AEFeinstein/Super-2025-Swadge-HW/art/james/pcb-silk-longdog.png

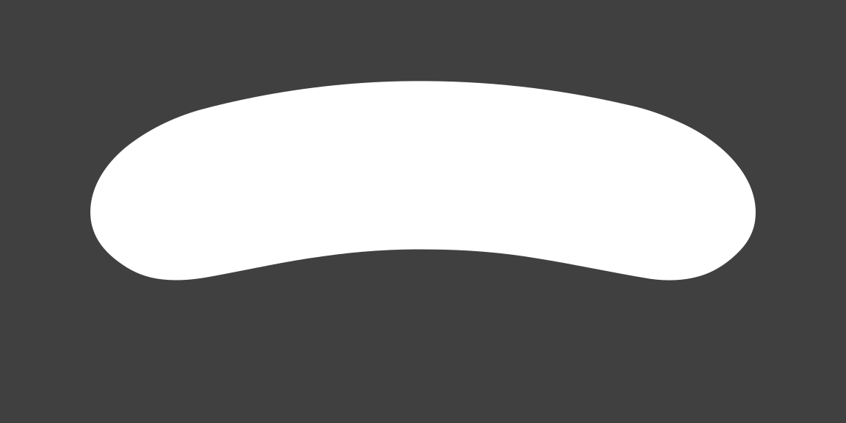
art/james/pcb-silk-longdog.png
