AEFeinstein/Super-2025-Swadge-HW/art/Silk rev A longdog.png

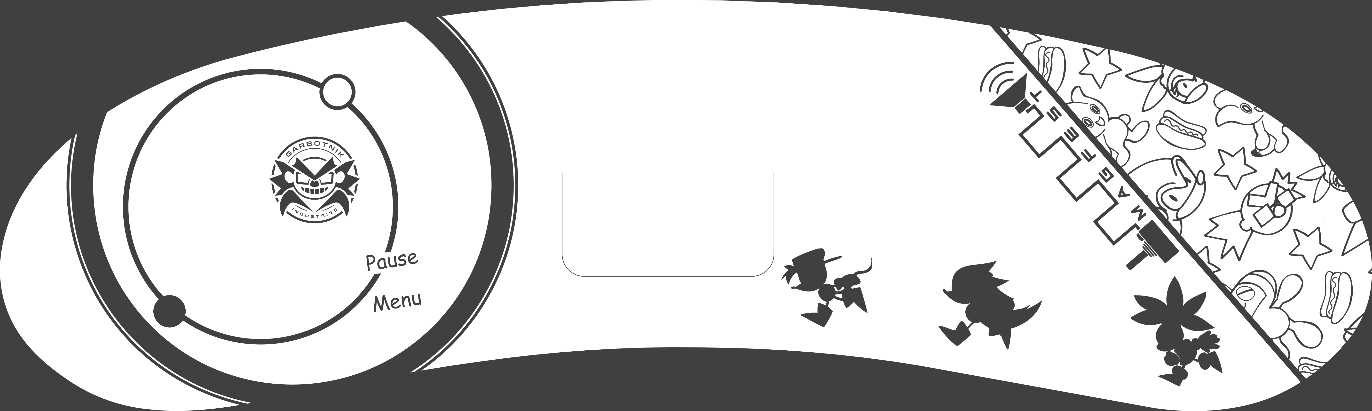
art/Silk rev A longdog.png
