AEFeinstein/Super-2025-Swadge-HW/Swadge-HW/Manufacturing Information/Hot Dog Quotation.xlsx

Sheet: PCB Specification
Your PCB Specification |  | Your PCB Specification
PCB Quantity | 725pcs | PCB Quantity | 1725pcs
Layer | 2layer | Layer | 2layer
PCB Thickness | 1.6mm | PCB Thickness | 1.6mm
Dimensions | 100mm*100mm | Dimensions | 100mm*100mm
Castellated Hole | No | Castellated Hole | No
PCB Color | Red | PCB Color | Black
Surface Finish | HASL Lead Free | Surface Finish | HASL Lead Free
Copper Weight | 1oz | Copper Weight | 1oz
Text Color | White | Text Color | White
Different Design | 1 | Different Design | 1
Please find more PCB information on our on-line PCB ordering Page
https://www.elecrow.com/pcb-manufacturing.html
 | Changelog:
October 11 2024 | Change PCB qty to 725 red + 1725 black, total qty 2450
October 11 2024 | Change surface finish to HASL LEAD FREE
October 11 2024 | Change C26 component
October 14 2024 | DNP U10, remove part from BOM and position file
October 14 2024 | DNP C21, remove part from BOM and position file
October 21 2014 | Add R19

Sheet: BOM
Project Name
# | Reference | QTY | Value | Package | Manufacturer Part number | Description | SMD | THT | Original | Elecrow PN | Note
1 | BT1, BT2, BT3 | 3 | Battery | 2460 | 36-2460-ND |  |  | 3 |  |  | Use through-hole AA Battery Holder in Style of Keystone 2460. Two fins hold batteries, not four fins.
2 | C1, C11, C14, C15, C17, C19, C24, C4, C5, C6 | 10 | 1μF | C_0603_1608Metric |  |  | 10 |  |  | C15849
3 | C10, C13, C16, C23, C25, C3 | 6 | 0.1μF | C_0603_1608Metric |  |  | 6 |  |  | C282519
4 | C12, C2, C20, C22, C7 | 5 | 22μF | C_0603_1608Metric |  |  | 5 |  |  | C159801
5 | C18 | 1 | 0.39uF | C_0603_1608Metric |  |  | 1 |  |  | C376833
6 | C26 | 1 | 470uF | C_Radial_D6.3_L5.8_P5.34 |  |  | 1 |  |  | C7465562
7 | C9 | 1 | 4.7nF | C_0603_1608Metric |  |  | 1 |  |  | C53987
8 | D1, D2, D3, D4, D5, D6, D7, D8, D9 | 9 | LC8812B-4020 | 4020PAD |  |  | 9 |  |  | C5446701
9 | D10, D12 | 2 | D | D_SMA | 2616-GS1J-ND |  | 2 |  |  | C22452
10 | D11 | 1 | SP0503BAHT | SOT-143 | F2715CT-ND |  | 1 |  |  | C2682275
11 | J1 | 1 | SAO | PinSocket_2x03_P2.54mm_Vertical | SFH11-PBPC-D03-ST-BK-ND |  |  | 1 |  | C92272
12 | J2 | 1 | PJ-307C | PJ-307C |  |  |  | 1 |  | C16684
13 | L1 | 1 | 33uH_500mA | L_1210_3225Metric |  |  | 1 |  |  | C90317
14 | L3 | 1 | 2.2uH | L_1008_2520Metric |  |  | 1 |  |  | C216158
15 | MK1 | 1 | Microphone | INGHAi_MIC_GMI4013S-2C58DB |  |  | 1 |  |  | C529870
16 | P1 | 1 | USB_C_Plug_USB2.0 | USB_C_Receptacle_HRO_TYPE-C-31-M-12 |  |  |  | 1 |  | C2765186 | https://www.usb.org/sites/default/files/documents/usb_type-c.zip
17 | Q1 | 1 | Q_PMOS_GSD | SOT-23 |  |  | 1 |  |  | C2763847
18 | R1, R22, R24, R26, R7 | 5 | 10kΩ | R_0603_1608Metric |  |  | 5 |  |  | C25804
19 | R10, R11, R12, R15, R16, R17 | 6 | 510Ω | R_0603_1608Metric |  |  | 6 |  |  | C2907048
20 | R13, R14, R2, R4, R8 | 5 | 33Ω | R_0603_1608Metric |  |  | 5 |  |  | C23140
21 | R18, R27, R28, R6 | 4 | 5.1kΩ | R_0603_1608Metric |  |  | 2 |  |  | C23186
22 | R21, R25 | 2 | 43kΩ | R_0603_1608Metric |  |  | 2 |  |  | C23172
23 | R3 | 1 | 12kΩ | R_0603_1608Metric |  |  | 1 |  |  | C22790
24 | R5, R9 | 2 | 20kΩ | R_0603_1608Metric |  |  | 2 |  |  | C2907011
25 | R19 | 1 | 120Ω | R_0603_1608Metric |  |  | 1 |  |  | C313655
26 | RV1 | 1 | R_Potentiometer_US_SMD | RK10J11R001Y |  |  | 1 |  |  | C3020613
27 | SW1, SW2, SW3, SW4, SW5, SW6 | 6 | YTS-D003-1A | YTS-D003-1A | 2223-TS04-66-65-BK-100-SMT-ND |  | 6 |  |  | C2910918 | Use low operating force (100gf) SMT box tactile buttons
28 | SW7, SW8 | 2 | B3FS-4002P | B3FS4002P | SW1278CT-ND |  | 2 |  |  | C2929546 | Use standard 12mmx12mm SMT box tactile buttons with flat top. Similar to TS-1103S-B-A.
29 | SW9 | 1 | SW_SPDT_1825232-1 | 1825232-1 | A107673-ND |  |  | 1 |  | C393937 | Use SPDT slide switch. Similar to 1825232-1
30 | U1 | 1 | ESP32-S2-MINI-1 | ESP32-S2-MINI-1 |  |  | 1 |  |  | C3013908 | Use module w. 4MB Flash, 2MB PSRAM (N4R2)
31 | U2 | 1 | RB017A1505A | NULL | http://www.ronboe.com/index.html |  |  | 1 |  |  | Display
32 | U3 | 1 | MT3410 | SOT-23-5 |  |  | 1 |  |  | C883494 | May be FP6396, M3406, LP3220S, etc...
33 | U5 | 1 | RB017A1505A_Connector | HCTL HC-FPC-03-10-15RLTAG | A141392TR-ND |  | 1 |  |  | C3012328
34 | U6 | 1 | LSM6DSL | LGA-14_3x2.5mm_P0.5mm_LayoutBorder3x4y |  |  | 1 |  |  | C967633
35 | U7 | 1 | GENERIC_LDO_2.8 | SOT-23 |  |  | 1 |  |  | C347374
36 | U8 | 1 | FM8002A | SOP-8_3.9x4.9mm_P1.27mm |  |  | 1 |  |  | C94625
37 | U9 | 1 | INGHAi_GSPK2307P-8R1W | INGHAi GSPK2308P-8R0.5W | 102-2500-ND |  |  | 1 |  | C530531
 |  |  |  |  |  | total： | 79 | 9
 | Declare：
 | 1、If the component should be original like Digi-key or Mouser，the component must have complete Manufacture part number

Sheet: Parts Mapping
TOP
BOTTOM

Sheet: Position File
designator | footprint | pos_x | pos_y | layer | rotation
BT1 | 2460 | 211.806 | -110.3999 | bottom | 100
BT2 | 2460 | 155.955 | -102.55 | bottom | 180
BT3 | 2460 | 103.314 | -107.7499 | bottom | -100
C1 | C_0603_1608Metric | 157.6413 | -69.0099 | bottom | 172
C10 | C_0603_1608Metric | 138.3615 | -119.986 | bottom | 180
C11 | C_0603_1608Metric | 150.7 | -82 | bottom | -90
C12 | C_0603_1608Metric | 136.95 | -123.1 | bottom | 180
C13 | C_0603_1608Metric | 139.3 | -125.35 | bottom | -90
C14 | C_0603_1608Metric | 139.3 | -88.0965 | bottom | 180
C15 | C_0603_1608Metric | 129.35 | -88.8375 | bottom | 90
C16 | C_0603_1608Metric | 150.0955 | -71.078 | bottom | 180
C17 | C_0603_1608Metric | 120.3 | -117.3245 | bottom | 15
C18 | C_0603_1608Metric | 142.5 | -91.05 | bottom | 0
C19 | C_0603_1608Metric | 147.45 | -68.5375 | bottom | -90
C2 | C_0603_1608Metric | 176.6815 | -73.3059 | bottom | -8
C20 | C_0603_1608Metric | 172.1 | -91.8 | bottom | 180
C22 | C_0603_1608Metric | 142.1875 | -77.65 | bottom | -90
C23 | C_0603_1608Metric | 145.02 | -67.7381 | bottom | 180
C24 | C_0603_1608Metric | 136.2875 | -131.05 | bottom | 150
C25 | C_0603_1608Metric | 145.02 | -69.4021 | bottom | 180
C26 | C_Radial_D6.3_L5.8_P5.34 | 118.7 | -105.6 | bottom | 0
C3 | C_0603_1608Metric | 176.465 | -74.8468 | bottom | -8
C4 | C_0603_1608Metric | 195.3375 | -117.65 | bottom | -15
C5 | C_0603_1608Metric | 154.3425 | -68.9 | bottom | 180
C6 | C_0603_1608Metric | 117.7666 | -125.5217 | bottom | -165
C7 | C_0603_1608Metric | 118.8086 | -127.8172 | bottom | -75
C9 | C_0603_1608Metric | 181.5 | -91.8 | bottom | 180
D1 | 4020PAD | 195.5392 | -116.0988 | top | 165
D10 | D_SMA | 146.3 | -82.6 | bottom | 0
D11 | SOT-143 | 182.694 | -127.5766 | bottom | -105
D12 | D_SMA | 179.1247 | -130.8254 | bottom | -15
D2 | 4020PAD | 209.9748 | -78.7385 | top | -30
D3 | 4020PAD | 156.543 | -67.5 | top | 0
D4 | 4020PAD | 98.3965 | -82.3592 | top | 40
D5 | 4020PAD | 119.4684 | -115.7178 | top | -165
D6 | 4020PAD | 104.4072 | -133.6721 | top | -38
D7 | 4020PAD | 137.3248 | -129.9215 | top | -30
D8 | 4020PAD | 170.3022 | -117.6524 | top | 144
D9 | 4020PAD | 214.6653 | -132.6465 | top | 130
J1 | PinSocket_2x03_P2.54mm_Vertical | 181.5965 | -71.2037 | top | 77
J2 | PJ-307C | 132.3093 | -68.0846 | bottom | -170
J3 | PinHeader_1x05_P2.54mm_Vertical | 191.979 | -71.4433 | bottom | -107
L1 | L_1210_3225Metric | 144.6 | -78.4 | bottom | 90
L3 | L_1008_2520Metric | 119.3434 | -131.6794 | bottom | 15
MK1 | INGHAi_MIC_GMI4013S-2C58DB | 177.7 | -103.4 | top | 0
P1 | USB_C_Receptacle_HRO_TYPE-C-31-M-12 | 187.0171 | -136.5052 | bottom | 165
Q1 | SOT-23 | 148.1 | -78.9 | bottom | 180
R1 | R_0603_1608Metric | 157.3629 | -70.9904 | bottom | -8
R10 | R_0603_1608Metric | 218.8959 | -92.5969 | bottom | -80
R11 | R_0603_1608Metric | 199.4067 | -96.3748 | bottom | -80
R12 | R_0603_1608Metric | 198.316 | -110.2211 | bottom | -74
R13 | R_0603_1608Metric | 188.2168 | -128.1482 | bottom | -105
R14 | R_0603_1608Metric | 190.1486 | -128.6659 | bottom | -105
R15 | R_0603_1608Metric | 202.5258 | -116.4901 | bottom | -39
R16 | R_0603_1608Metric | 225.2352 | -107.5296 | bottom | -90
R17 | R_0603_1608Metric | 197.5677 | -102.2035 | bottom | -15
R18 | R_0603_1608Metric | 142 | -118 | bottom | 0
R19 | R_0603_1608Metric | 138.7 | -77.6375 | bottom | 90
R2 | R_0603_1608Metric | 175.25 | -91.8 | bottom | 180
R21 | R_0603_1608Metric | 123.5374 | -130.4454 | bottom | 105
R22 | R_0603_1608Metric | 124.7597 | -128.8928 | bottom | 105
R24 | R_0603_1608Metric | 123.828 | -125.9455 | bottom | 105
R25 | R_0603_1608Metric | 120.7762 | -124.7282 | bottom | -165
R26 | R_0603_1608Metric | 140.444 | -77.65 | bottom | -90
R27 | R_0603_1608Metric | 186.2849 | -127.6306 | bottom | -105
R28 | R_0603_1608Metric | 192.0805 | -129.1835 | bottom | -105
R3 | R_0603_1608Metric | 178.4 | -91.8 | bottom | 0
R4 | R_0603_1608Metric | 193.55 | -113.0625 | bottom | 90
R5 | R_0603_1608Metric | 136.1745 | -85.59 | bottom | 0
R6 | R_0603_1608Metric | 145 | -118 | bottom | 0
R7 | R_0603_1608Metric | 150.7 | -78.9 | bottom | 90
R8 | R_0603_1608Metric | 136.95 | -124.7 | bottom | 180
R9 | R_0603_1608Metric | 139.3 | -91.05 | bottom | 180
RV1 | RK10J11R001Y | 118.8665 | -73.302 | bottom | -152
SW1 | YTS-D003-1A | 105.7931 | -91.5931 | top | -45
SW2 | YTS-D003-1A | 111.45 | -97.25 | top | -135
SW3 | YTS-D003-1A | 100.1363 | -97.25 | top | 45
SW4 | YTS-D003-1A | 105.7931 | -102.9069 | top | 135
SW5 | YTS-D003-1A | 123.0715 | -108.7693 | top | -170
SW6 | YTS-D003-1A | 121.8351 | -101.7575 | top | -170
SW7 | B3FS4002P | 183.519 | -91.519 | top | 110
SW8 | B3FS4002P | 195.119 | -85.969 | top | 110
SW9 | 1825232-1 | 123.1681 | -134.7676 | bottom | -165
U1 | ESP32-S2-MINI-1 | 166.3469 | -77.0707 | bottom | 172
U2 | NULL | 69.0335 | -217.4483 | top | 0
U3 | SOT-23-5 | 121.4606 | -127.3789 | bottom | 105
U5 | HCTL HC-FPC-03-10-15RLTAG | 142.3 | -70.91 | top | 0
U6 | LGA-14_3x2.5mm_P0.5mm_LayoutBorder3x4y | 140.324 | -122.2735 | bottom | 180
U7 | SOT-23 | 150.046 | -68.468 | bottom | 0
U8 | SOP-8_3.9x4.9mm_P1.27mm | 133.981 | -89.099 | bottom | 180
U9 | INGHAi GSPK2308P-8R0.5W | 123.0569 | -85.5883 | top | -3
