AEFeinstein/Super-2025-Swadge-HW/Swadge-HW/Manufacturing Information/Template-for-PCBA-Quotation.xlsx

Sheet: PCB Specification
Your PCB Specification
PCB Quantity | 1000pcs
Layer | 2layer
PCB Thickness | 1.6mm
Dimensions | 100mm*100mm
Castellated Hole | No
PCB Color | Blue
Surface Finish | HASL Lead Free
Copper Weight | 1oz
Text Color | White
Different Design | 1
Please find more PCB information on our on-line PCB ordering Page
https://www.elecrow.com/pcb-manufacturing.html

Sheet: BOM
Project Name
# | Reference | QTY | Value | Package | Manufacturer Part number | Description | SMD | THT | Original | Elecrow PN | Note
1 | BUZZ | 1 | PKMCS0909E4000-R1 | PKMCS0909E4000-R1 | 490-9647-1-ND |  | 2 |  | Y
2 | C1,C3-5 | 4 | 0.1u | CJ1608 | 609-3263-ND | Capacitors | 8 |  | N | 2013010A
3 | C2,C6 | 2 | 4.7u | CJ1608 | 609-3263-ND | Capacitors | 4 |  | N | 2014547A
4 | CN1 | 1 | AVRISP | 2X3_PINHEADER_SMD | WM17449-ND |  | 6 |  | N
5 | D1 | 1 | 1N4148WS | SOD323 | 609-3263-ND |  | 2 |  | Y | 4010541A
6 | IC1 | 1 | ATMEGA328P-20MU | QFN32-0.5 | ATMEGA328P-MU-ND | ATMEL AVR | 32 |  | Y
7 | IC2 | 1 | TCR2EF33LM | SOT-23-5PIN | TCR2EF33LM(CTCT-ND |  | 5 |  | Y
8 | JP1 | 1 |  | JST-2-SMD | 455-1749-1-ND | Header 2 | 4 |  | N
9 | JP4 | 1 | FTDI Basic | 1X06 | 609-3263-ND |  |  | 6 | N
10 | LED1 | 1 | OSTG1608C1A | CHIP-LED0603 | 609-3264-ND | LED | 2 |  | N | 4040706A
11 | R1,R13 | 2 | 1k | RJ1608 | 609-3268-ND | Resistors | 4 |  | N | 1022501A
12 | R2 | 1 | 100k | RJ1608 | 609-3269-ND | Resistors | 2 |  | N | 10240102A
13 | R3,R6,R7,R12 | 4 | 330 | RJ1608 | 609-3270-ND | Resistors | 8 |  | N | 1021633A
14 | R4,R5,R8,R10,R11, | 5 | 10k | RJ1608 | 609-3271-ND | Resistors | 16 |  | N | 1023510A
15 | R9 | 1 | 2k | RJ1608 | 609-3272-ND | Resistors | 2 |  | N | 1022622B
16 | VR1 | 1 | 50k |  | CT6EP503-ND |  |  | 3 | N
17 | RESET,SW2-4 | 4 | PUSHSW2-6X6 | ALPS-SKHH | CT6EP504-ND |  |  | 16 | N | 7020644A
18 | T1,T2 | 2 | 2SC2712 | SOT23-BEC | 2SC2712-GRLFCT-ND | NPN Transistor | 6 |  | Y
19 | T3-5 | 3 | BSS138 | SOT-23 | BSS138CT-ND |  | 9 |  | Y
20 | U2 | 1 | MCP73831 | SOT-23-5PIN | MCP73831T-2ACI/OTCT-ND |  | 5 |  | Y
21 | U3 | 1 |  | USB-MICRO-SMD | MCP73831T-3ACI/OTCT | This is a USB AB connector that is compatible with USB OTG. i.e. this connector can serve as a host or device | 7 |  | N | 6020800A
22 | Y1 | 1 | RESONATORPBRC-M | PBRC-M | 1253-1018-1-ND | Resonator | 3 |  | N
 |  |  |  |  |  | total： | 127 | 25
 | Declare：
 | 1、If the component should be original like Digi-key or Mouser，the component must have complete Manufacture part number

Sheet: Position File
Designator | Footprint | Center-X(mm) | Center-Y(mm) | Layer | Rotation
R27 | R0603 | 80478 | 54614 | BottomLayer | 360
R27 | R0603 | 126678 | 54614 | BottomLayer | 360
R27 | R0603 | 80478 | 23614 | BottomLayer | 360
R27 | R0603 | 126678 | 23614 | BottomLayer | 360
R26 | R0603 | 70648 | 54995 | BottomLayer | 360
R26 | R0603 | 116848 | 54995 | BottomLayer | 360
R26 | R0603 | 70648 | 23995 | BottomLayer | 360
R26 | R0603 | 116848 | 23995 | BottomLayer | 360
R25 | R0603 | 80478 | 56646 | BottomLayer | 180
R25 | R0603 | 126678 | 56646 | BottomLayer | 180
R25 | R0603 | 80478 | 25646 | BottomLayer | 180
R25 | R0603 | 126678 | 25646 | BottomLayer | 180
R24 | R0603 | 70648 | 57027 | BottomLayer | 180
R24 | R0603 | 116848 | 57027 | BottomLayer | 180
R24 | R0603 | 70648 | 26027 | BottomLayer | 180
R24 | R0603 | 116848 | 26027 | BottomLayer | 180
Q21 | SOT-23 | 77010 | 55683 | BottomLayer | 90
Q21 | SOT-23 | 123210 | 55683 | BottomLayer | 90
Q21 | SOT-23 | 77010 | 24683 | BottomLayer | 90
Q21 | SOT-23 | 123210 | 24683 | BottomLayer | 90
Q20 | SOT-23 | 65949 | 56036 | BottomLayer | 90
Q20 | SOT-23 | 112149 | 56036 | BottomLayer | 90
Q20 | SOT-23 | 65949 | 25036 | BottomLayer | 90
Q20 | SOT-23 | 112149 | 25036 | BottomLayer | 90
Q2 | SOT95P240X120-3N | 36573 | 27516 | BottomLayer | 180
Q2 | SOT95P240X120-3N | 7573 | 27516 | BottomLayer | 180
Q2 | SOT95P240X120-3N | 36573 | 58516 | BottomLayer | 180
Q2 | SOT95P240X120-3N | 7573 | 58516 | BottomLayer | 180
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
C5 | C0805 | 47434 | 46748 | TopLayer | 90
C5 | C0805 | 18434 | 46748 | TopLayer | 90
C2 | C0805 | 36258 | 28067 | TopLayer | 180
C2 | C0805 | 7258 | 28067 | TopLayer | 180
C2 | C0805 | 36258 | 59067 | TopLayer | 180
C2 | C0805 | 7258 | 59067 | TopLayer | 180
