AEFeinstein/Super-2025-Swadge-HW/art/james/condiment-longdog.dxf

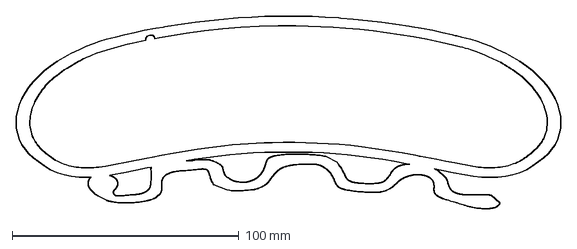
[picture p3: CAD file, 2024-11-29]
art/james/condiment-longdog.dxf
240.1 x 84.8 mm
