AEFeinstein/Super-2025-Swadge-HW/Swadge-HW/Manufacturing Information/condiment.dxf

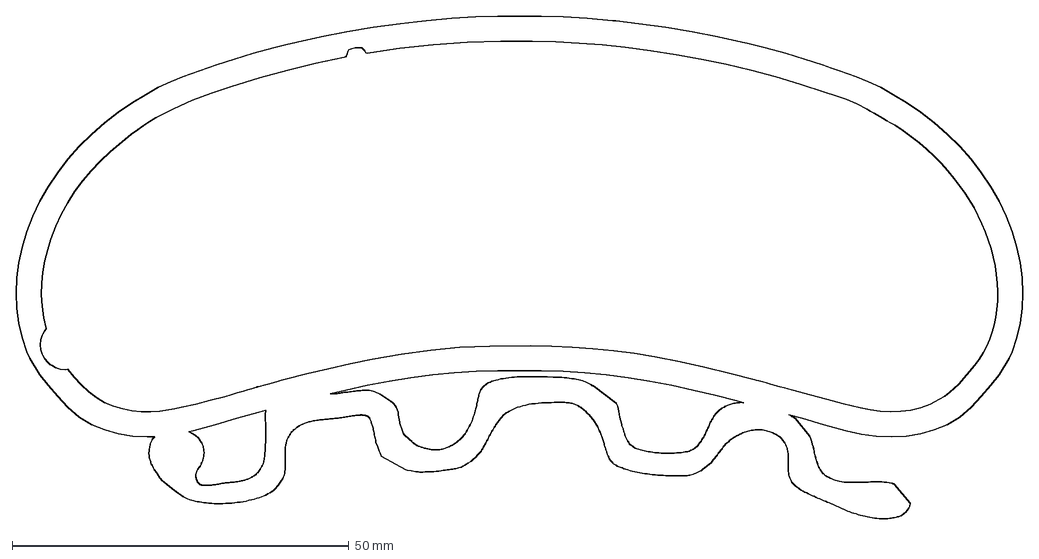
[picture p4: CAD file, 2024-11-15]
Swadge-HW/Manufacturing Information/condiment.dxf
149.5 x 74.6 mm
