AEFeinstein/Super-2025-Swadge-HW/Swadge-HW/package3d/condiment.step

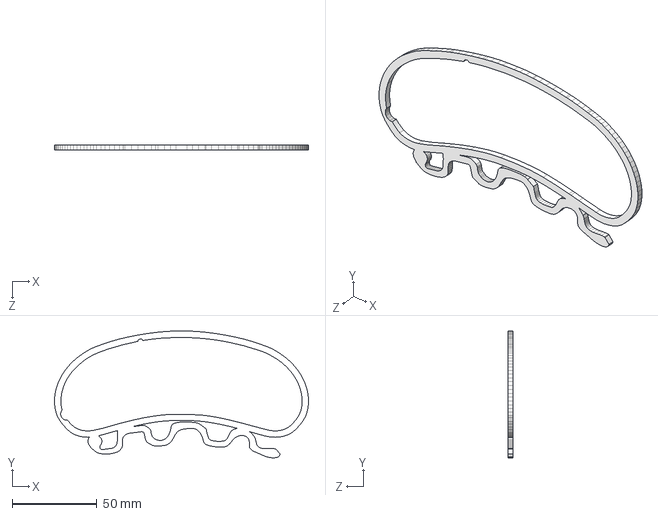
[picture p5: CAD file, 2024-11-15]
Swadge-HW/package3d/condiment.step
149.5 x 74.6 x 3.00 mm
