AEFeinstein/Super-2025-Swadge-HW/Swadge-HW/Swadge-HW.kicad_pcb

## KiCad design Swadge-HW/Swadge-HW.kicad_pcb (2024-11-20)

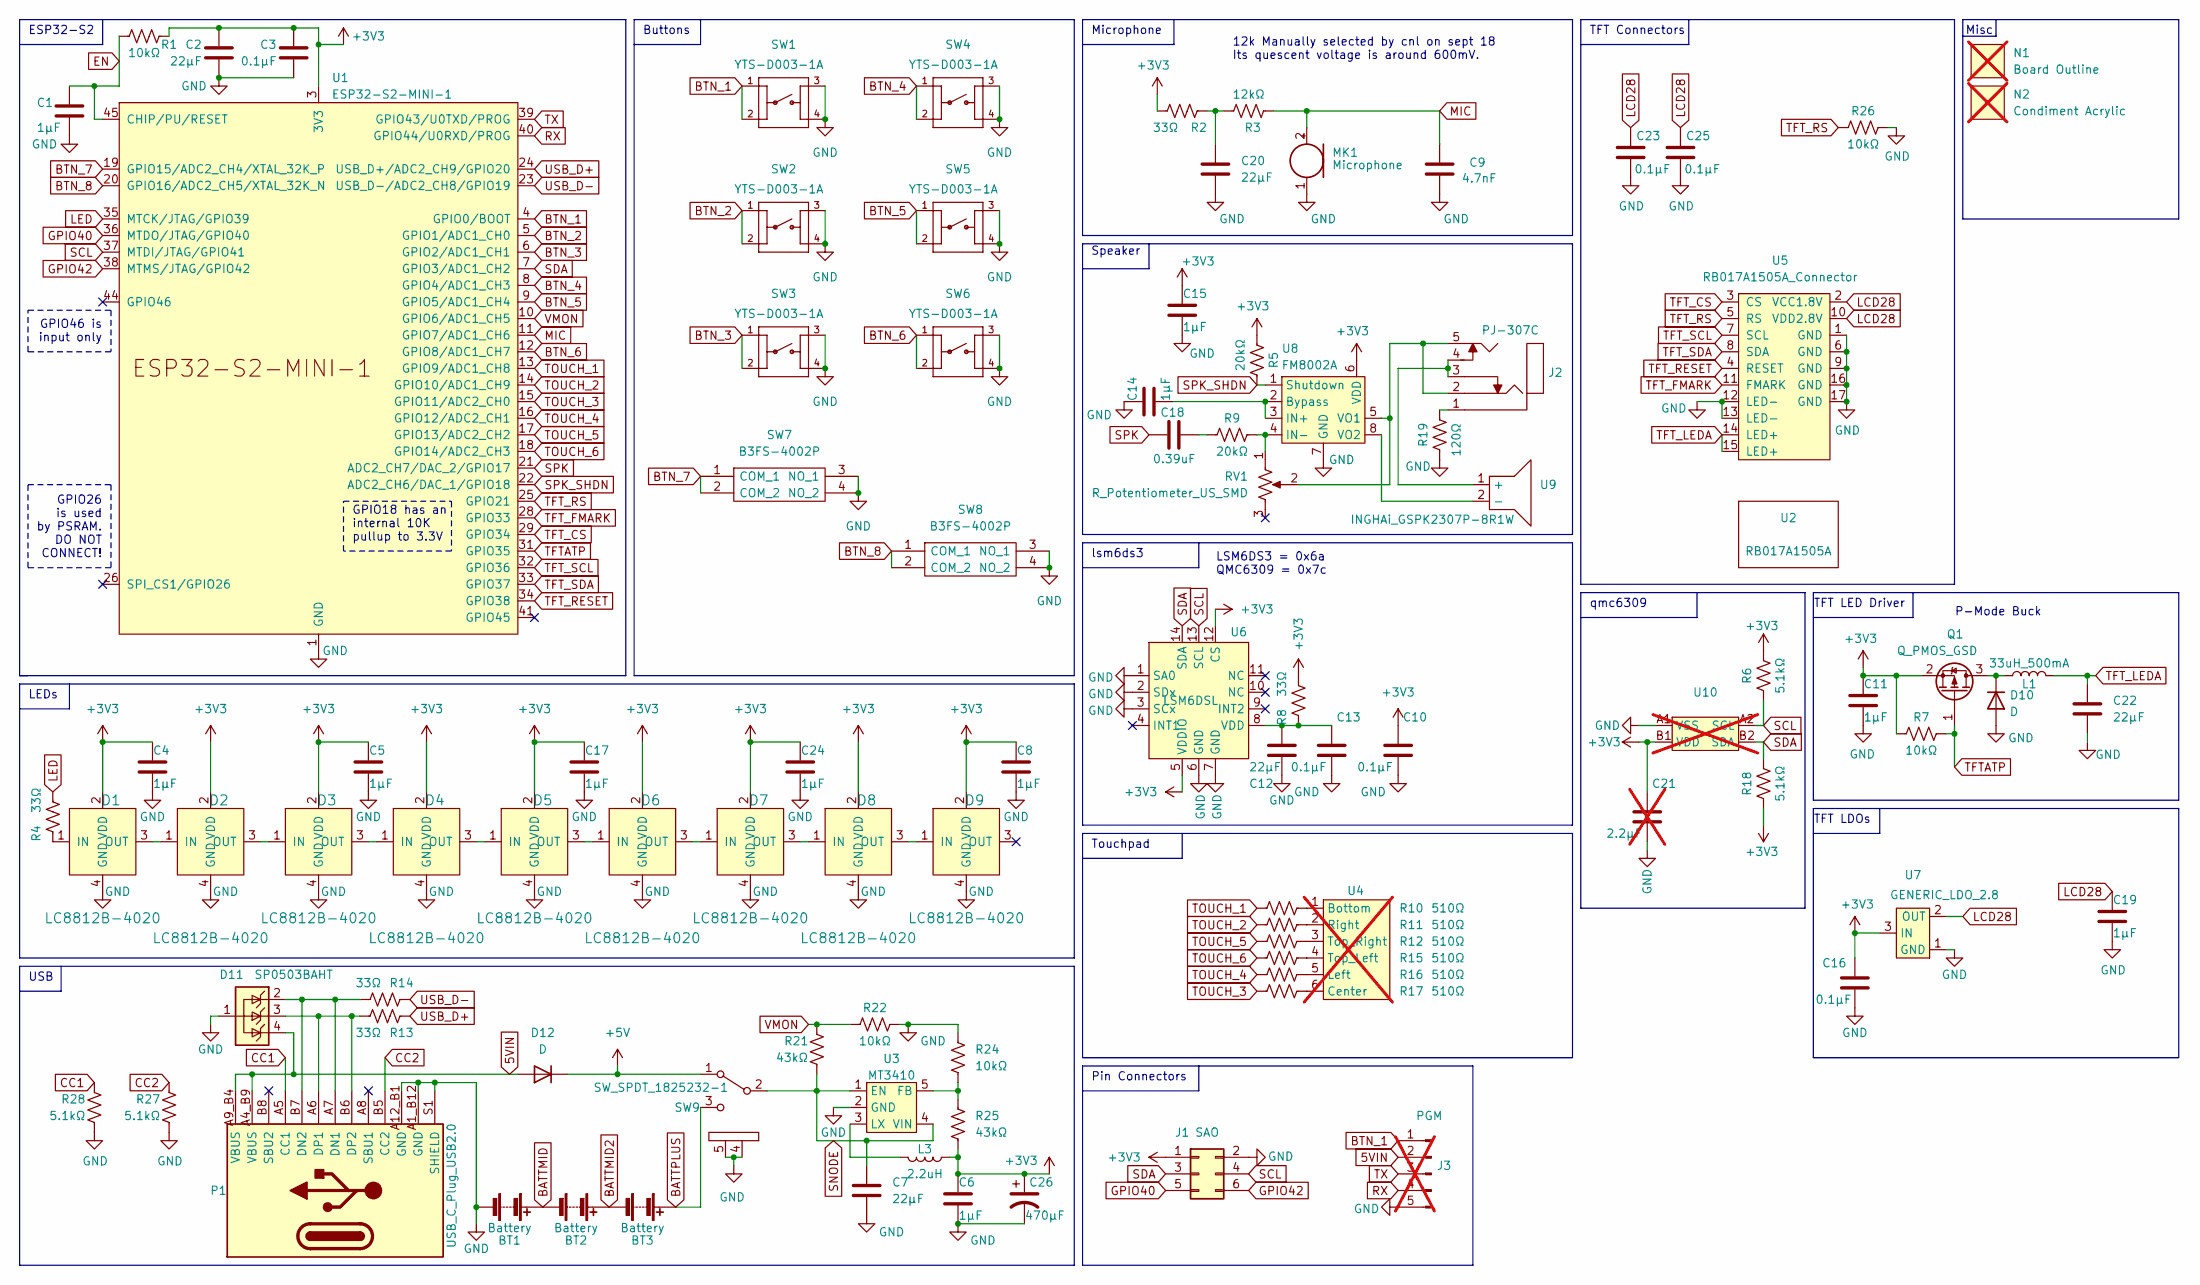
[picture p6: schematic Swadge-HW.kicad_sch]

Parts:
BT1, BT2, BT3: Battery; 2460; Digikey 36-2460-ND
C1, C4, C5, C6, C8, C11, C14, C15, C17, C19, C24: 1μF; C_0603_1608Metric; LCSC C15849
C2, C7, C12, C20, C22: 22μF; C_0603_1608Metric; LCSC C159801
C3, C10, C13, C16, C23, C25: 0.1μF; C_0603_1608Metric; LCSC C282519
C9: 4.7nF; C_0603_1608Metric; LCSC C53987
C18: 0.39uF; C_0603_1608Metric; LCSC C376833
C21: 2.2μF; C_0603_1608Metric; LCSC C6119848; not fitted
C26: 470μF; C_Radial_D6.3_L5.8_P5.34; LCSC C7465562
D1, D2, D3, D4, D5, D6, D7, D8, D9: LC8812B-4020; 4020PAD; LCSC C5446701
D10, D12: D; D_SMA; Digikey 2616-GS1J-ND
D11: SP0503BAHT; SOT-143; Digikey F2715CT-ND
J1: SAO; PinSocket_2x03_P2.54mm_Vertical; LCSC C92272
J2: PJ-307C; LCSC C16684
J3: PGM; PinHeader_1x05_P2.54mm_Vertical; not fitted
L1: 33uH_500mA; L_1210_3225Metric; LCSC C90317
L3: 2.2uH; L_1008_2520Metric; LCSC C216158
MK1: Microphone; INGHAi_MIC_GMI4013S-2C58DB; LCSC C529870
N1: Board Outline; hotdog-outline; not fitted
N2: Condiment Acrylic; condiment; not fitted
P1: USB_C_Plug_USB2.0; USB_C_Receptacle_HRO_TYPE-C-31-M-12; LCSC C2765186
Q1: Q_PMOS_GSD; SOT-23; LCSC C2763847
R1, R7, R22, R24, R26: 10kΩ; R_0603_1608Metric; LCSC C25804
R2, R4, R8, R13, R14: 33Ω; R_0603_1608Metric; LCSC C23140
R3: 12kΩ; R_0603_1608Metric; LCSC C22790
R5, R9: 20kΩ; R_0603_1608Metric; LCSC C2907011
R6, R18, R27, R28: 5.1kΩ; R_0603_1608Metric; LCSC C23186
R10, R11, R12, R15, R16, R17: 510Ω; R_0603_1608Metric; LCSC C2907048
R19: 120Ω; R_0603_1608Metric; LCSC C313655
R21, R25: 43kΩ; R_0603_1608Metric; LCSC C23172
RV1: R_Potentiometer_US_SMD; RK10J11R001Y; LCSC C3020613
SW1, SW2, SW3, SW4, SW5, SW6: YTS-D003-1A; Digikey 2223-TS04-66-65-BK-100-SMT-ND
SW7, SW8: B3FS-4002P; B3FS4002P; Digikey SW1278CT-ND
SW9: SW_SPDT_1825232-1; 1825232-1; Digikey A107673-ND
U1: ESP32-S2-MINI-1; LCSC C3013908
U2: RB017A1505A; NULL
U3: MT3410; SOT-23-5; LCSC C883494
U4: Touch_Teeth_5b; not fitted
U5: RB017A1505A_Connector; HCTL HC-FPC-03-10-15RLTAG; Digikey A141392TR-ND
U6: LSM6DSL; LGA-14_3x2.5mm_P0.5mm_LayoutBorder3x4y; LCSC C967633
U7: GENERIC_LDO_2.8; SOT-23; LCSC C347374
U8: FM8002A; SOP-8_3.9x4.9mm_P1.27mm; LCSC C94625
U9: INGHAi_GSPK2307P-8R1W; INGHAi GSPK2308P-8R0.5W; Digikey 102-2500-ND
U10: BGA-4-.83x.83; LCSC C5439871; not fitted

Connections:
5VIN: D11.4 (K), D12.2 (A), J3.2, P1.A4_B9 (VBUS), P1.A9_B4 (VBUS)
+3V3: C2.1, C3.1, C4.1, C5.1, C6.1, C8.1, C10.1, C11.1, C15.1, C16.1, C17.1, C21.1, C24.1, C26.1, D1.2 (VDD), D2.2 (VDD), D3.2 (VDD), D4.2 (VDD), D5.2 (VDD), D6.2 (VDD), D7.2 (VDD), D8.2 (VDD), D9.2 (VDD), J1.1, L3.1, Q1.2 (S), R1.1, R2.2, R5.1, R6.2, R7.1, R8.2, R18.1, R25.2, U1.3 (3V3), U6.5 (VDDIO), U6.12 (CS), U7.3 (IN), U8.6 (VDD), U10.B1 (VDD)
+5V: D12.1 (K), SW9.1 (A)
BATTMID: BT1.1 (+), BT2.2 (-)
BATTMID2: BT2.1 (+), BT3.2 (-)
BATTPLUS: BT3.1 (+), SW9.3 (C)
BTN_1: J3.1, SW1.1, SW1.2, U1.4 (GPIO0/BOOT)
BTN_2: SW2.1, SW2.2, U1.5 (GPIO1/ADC1_CH0)
BTN_3: SW3.1, SW3.2, U1.6 (GPIO2/ADC1_CH1)
BTN_4: SW4.1, SW4.2, U1.8 (GPIO4/ADC1_CH3)
BTN_5: SW5.1, SW5.2, U1.9 (GPIO5/ADC1_CH4)
BTN_6: SW6.1, SW6.2, U1.12 (GPIO8/ADC1_CH7)
BTN_7: SW7.1 (COM_1), SW7.2 (COM_2), U1.19 (GPIO15/ADC2_CH4/XTAL_32K_P)
BTN_8: SW8.1 (COM_1), SW8.2 (COM_2), U1.20 (GPIO16/ADC2_CH5/XTAL_32K_N)
CC1: P1.A5 (CC1), R28.2
CC2: P1.B5 (CC2), R27.2
EN: C1.1, R1.2, U1.45 (CHIP/PU/RESET)
GND: BT1.2 (-), C1.2, C2.2, C3.2, C4.2, C5.2, C6.2, C7.2, C8.2, C9.1, C10.2, C11.2, C12.2, C13.2, C14.1, C15.2, C16.2, C17.2, C19.2, C20.2, C21.2, C22.2, C23.2, C24.2, C25.2, C26.2, D1.4 (GND), D2.4 (GND), D3.4 (GND), D4.4 (GND), D5.4 (GND), D6.4 (GND), D7.4 (GND), D8.4 (GND), D9.4 (GND), D10.2 (A), D11.1 (A), J1.2, J3.5, MK1.1 (-), P1.A1_B12 (GND), P1.A12_B1 (GND), P1.S1 (SHIELD), R19.1, R22.2, R24.1, R26.2, R27.1, R28.1, SW1.3, SW1.4, SW2.3, SW2.4, SW3.3, SW3.4, SW4.3, SW4.4, SW5.3, SW5.4, SW6.3, SW6.4, SW7.3 (NO_1), SW7.4 (NO_2), SW8.3 (NO_1), SW8.4 (NO_2), SW9.4 (D), SW9.5 (E), U1.1 (GND), U1.2 (GND), U1.30 (GND), U1.42 (GND), U1.43 (GND), U1.46 (GND), U1.47 (GND), U1.48 (GND), U1.49 (GND), U1.50 (GND), U1.51 (GND), U1.52 (GND), U1.53 (GND), U1.54 (GND), U1.55 (GND), U1.56 (GND), U1.57 (GND), U1.58 (GND), U1.59 (GND), U1.60 (GND), U1.61 (GND), U1.62 (GND), U1.63 (GND), U1.64 (GND), U1.65 (GND), U3.2 (GND), U5.1 (GND), U5.6 (GND), U5.9 (GND), U5.12 (LED-), U5.13 (LED-), U5.16 (GND), U5.17 (GND), U6.1 (SA0), U6.2 (SDx), U6.3 (SCx), U6.6 (GND), U6.7 (GND), U7.1 (GND), U8.7 (GND), U10.A1 (VSS)
GPIO40: J1.5, U1.36 (MTDO/JTAG/GPIO40)
GPIO42: J1.6, U1.38 (MTMS/JTAG/GPIO42)
LCD28: C19.1, C23.1, C25.1, U5.2 (VCC1.8V), U5.10 (VDD2.8V), U7.2 (OUT)
LED: R4.2, U1.35 (MTCK/JTAG/GPIO39)
MIC: C9.2, MK1.2 (+), R3.2, U1.11 (GPIO7/ADC1_CH6)
unnamed: C18.1, R9.1
unnamed: C20.1, R2.1, R3.1
unnamed: D1.1 (IN), R4.1
unnamed: D1.3 (OUT), D2.1 (IN)
unnamed: D2.3 (OUT), D3.1 (IN)
unnamed: D3.3 (OUT), D4.1 (IN)
unnamed: D4.3 (OUT), D5.1 (IN)
unnamed: D5.3 (OUT), D6.1 (IN)
unnamed: D6.3 (OUT), D7.1 (IN)
unnamed: D7.3 (OUT), D8.1 (IN)
unnamed: D8.3 (OUT), D9.1 (IN)
unnamed: D10.1 (K), L1.1, Q1.3 (D)
unnamed: J2.1, R19.2
unnamed: D11.2 (K), P1.A7 (DN1), P1.B7 (DN2), R14.2
unnamed: D11.3 (K), P1.A6 (DP1), P1.B6 (DP2), R13.2
unnamed: R24.2, R25.1, U3.5 (FB)
unnamed: L3.2, U3.3 (LX)
unnamed: R10.2, U4.1 (Bottom)
unnamed: R17.2, U4.6 (Center)
unnamed: R16.2, U4.5 (Left)
unnamed: R11.2, U4.2 (Right)
unnamed: R15.2, U4.4 (Top_Left)
unnamed: R12.2, U4.3 (Top_Right)
unnamed: C12.1, C13.1, R8.1, U6.8 (VDD)
unnamed: C14.2, U8.2 (Bypass), U8.3 (IN+)
unnamed: R9.2, RV1.1, U8.4 (IN-)
unnamed: J2.2, J2.5, RV1.2, U8.5 (VO1)
unnamed: U8.8 (VO2), U9.2 (-)
unnamed: J2.3, J2.4, U9.1 (+)
RX: J3.4, U1.40 (GPIO44/U0RXD/PROG)
SCL: J1.4, R6.1, U1.37 (MTDI/JTAG/GPIO41), U6.13 (SCL), U10.A2 (SCL)
SDA: J1.3, R18.2, U1.7 (GPIO3/ADC1_CH2), U6.14 (SDA), U10.B2 (SDA)
SNODE: C7.1, R21.2, SW9.2 (B), U3.1 (EN), U3.4 (VIN)
SPK: C18.2, U1.21 (ADC2_CH7/DAC_2/GPIO17)
SPK_SHDN: R5.2, U1.22 (ADC2_CH6/DAC_1/GPIO18), U8.1 (Shutdown)
TFTATP: Q1.1 (G), R7.2, U1.31 (GPIO35)
TFT_CS: U1.29 (GPIO34), U5.3 (CS)
TFT_FMARK: U1.28 (GPIO33), U5.11 (FMARK)
TFT_LEDA: C22.1, L1.2, U5.14 (LED+), U5.15 (LED+)
TFT_RESET: U1.34 (GPIO38), U5.4 (RESET)
TFT_RS: R26.1, U1.25 (GPIO21), U5.5 (RS)
TFT_SCL: U1.32 (GPIO36), U5.7 (SCL)
TFT_SDA: U1.33 (GPIO37), U5.8 (SDA)
TOUCH_1: R10.1, U1.13 (GPIO9/ADC1_CH8)
TOUCH_2: R11.1, U1.14 (GPIO10/ADC1_CH9)
TOUCH_3: R17.1, U1.15 (GPIO11/ADC2_CH0)
TOUCH_4: R16.1, U1.16 (GPIO12/ADC2_CH1)
TOUCH_5: R12.1, U1.17 (GPIO13/ADC2_CH2)
TOUCH_6: R15.1, U1.18 (GPIO14/ADC2_CH3)
TX: J3.3, U1.39 (GPIO43/U0TXD/PROG)
USB_D+: R13.1, U1.24 (USB_D+/ADC2_CH9/GPIO20)
USB_D-: R14.1, U1.23 (USB_D-/ADC2_CH8/GPIO19)
VMON: R21.1, R22.1, U1.10 (GPIO6/ADC1_CH5)

Notes on the sheet:
Pin Connectors
GPIO46 is input only
TFT LDOs
P-Mode Buck
Touchpad
lsm6ds3
Speaker
LSM6DS3 = 0x6a QMC6309 = 0x7c
12k Manually selected by cnl on sept 18 Its quescent voltage is around 600mV.
Buttons
GPIO26 is used by PSRAM. DO NOT CONNECT!
qmc6309
ESP32-S2
GPIO18 has an internal 10K pullup to 3.3V
Microphone
LEDs
TFT LED Driver
TFT Connectors
USB
Misc

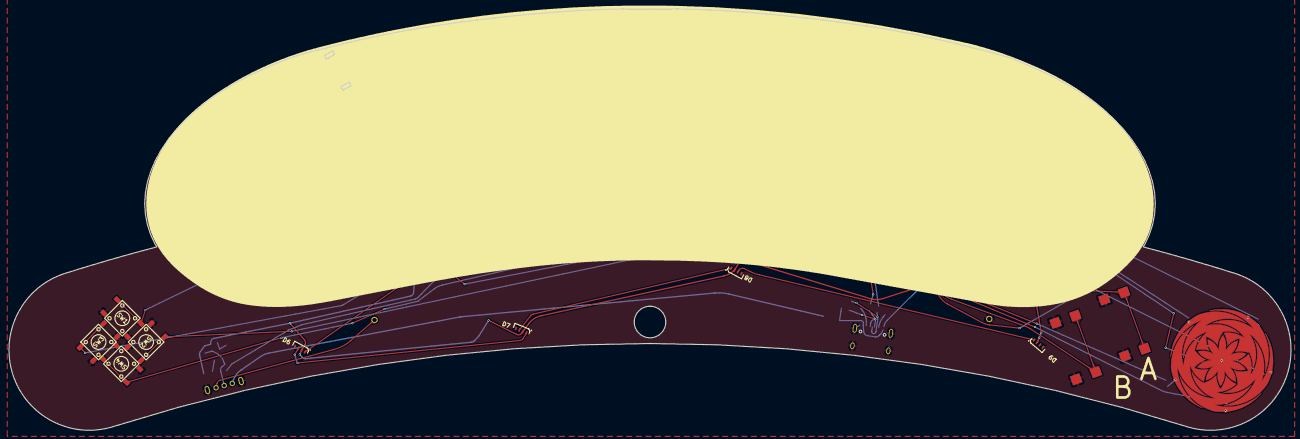
[picture p7: board Swadge-HW.kicad_pcb from above]

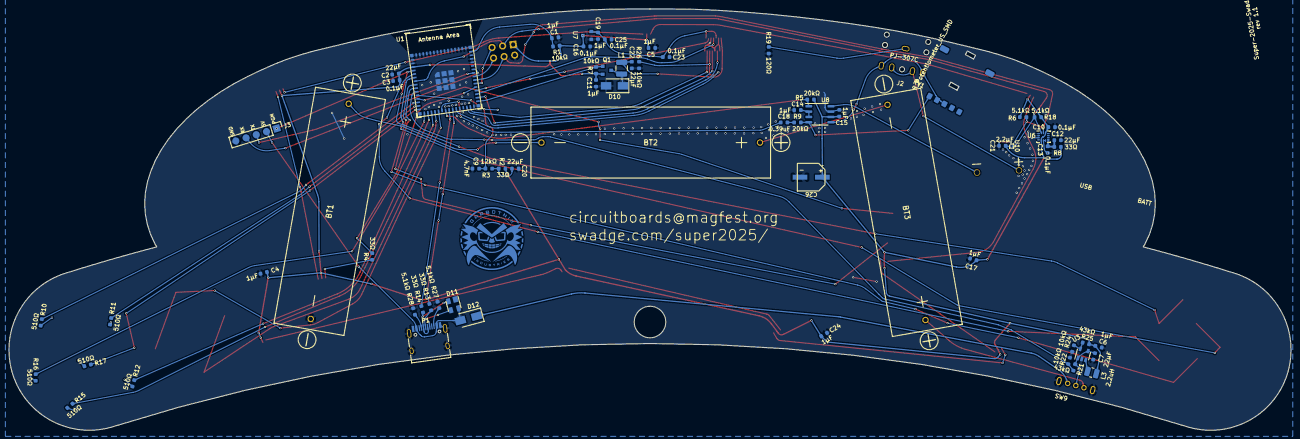
[picture p8: board Swadge-HW.kicad_pcb from below]

Board: 2 copper layers, 305.0 x 100.2 mm, 96 parts (71 on the bottom side), 76 nets.
