AEFeinstein/Super-2025-Swadge-HW/(threads)

Thread 1 (2024-05-04):

Add ESD Resistors to Touchpads

AEFeinstein, 2024-05-04:
From Elecrow:
> We got the analysis result from the supplier. The reason is that the recommended design for this module requires a 510 Ω resistor to be connected in series with the touch pins to avoid ESD breakdown, which is not done in your design. Your BOM also does not have a 510 ohm resistor. Please remember to modify it next time.
>
> 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

Thread 2 (2024-05-08):

Switch Buzzers to Speaker

AEFeinstein, 2024-05-08:
The Speaker SAO schematic is here, feel free to transpose it if it's up to snuff.
https://github.com/AEFeinstein/swadge-sao

Things to check:
- [ ] Do we want a volume dial, or software volume control?
- [ ] Do we want both speaker and headphone jack? Would headphones be provided? If they are, is a speaker necessary?
- [ ] The speaker output seems to clip at higher volumes, why?
- [ ] Make sure the headphone jack works with a mono plug

Closed 2024-07-29.

Thread 3 (2024-05-08):

No Shorts!

AEFeinstein, 2024-05-08:
If the lanyard or mounting holes are plated, and connected to GND, make absolutely sure that a lanyard clip can't connect an unintentional short.

Thread 7 (2024-10-07):

C26 Footprint is incorrect

emilyanthony4244, 2024-10-07:
Did you know there is a difference between nF and uF? I sure did. However, I made a mistake and referenced the 470nF cap footprint for C26, the big boi electrolytic cap. I caught it in a BOM review.

TODO:

1. Update existing or add to Swadge_Parts LCSC C7465562 470**u**F electrolytic capacitor
2. Replace C26 with this part
3. Change location
4. Regenerate mfg data for Elecrow

https://www.lcsc.com/product-detail/Aluminum-Electrolytic-Capacitors-SMD_ROQANG-RVE1A471M0605_C7465562.html

AEFeinstein, 2024-10-07:
Hmmm, you know what the problem is? You got it set to "n" for nano, when it should be set to "u" for "micro".

[turns the n on the capacitor upside down]

AEFeinstein, 2024-10-07:
(also move the big boi up so it's nestled between the batteries)

emilyanthony4244, 2024-10-07:
fixed

Closed 2024-10-07.
