AEFeinstein/Super-2025-Swadge-HW/(commit log)

2024-10-06 Add longdog footprint
    longdog
2024-11-15 longdog
    longdog layout
    [Swadge-HW.kicad_pcb]
2024-11-15 art adjustment
    [Swadge-HW.kicad_pcb]
2024-11-18 shape and routing
    [Swadge-HW.kicad_pcb, condiment-longdog.dxf]
2024-11-20 generated mfg files for quoting
    [Swadge-HW.kicad_pcb]
2024-11-29 Mfg data
    [condiment-longdog.dxf]
2024-12-16 longdog 1.1
    edit BGA traces for manufacturability
2025-01-13 fix ground issue
    connected ground planes for D4 and power circuit
2025-01-13 mfg files
    gerber data upload
2025-01-14 * Add Vias * Increase size of power rails
2025-01-29 Update with charles's understanding of ground loops - there's still possibly a power fuzz issue but I am curious how it turns out.
